JinalkaHerath/Flight_Controller-STM32/schematics/PCB_V2-INNERLAYER.jpg

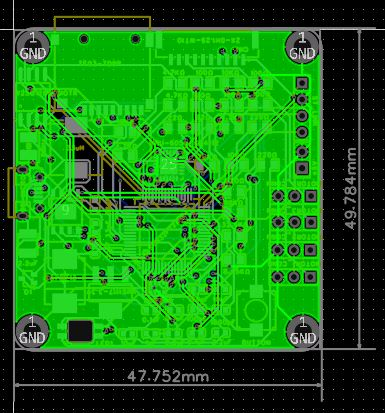
schematics/PCB_V2-INNERLAYER.jpg
