JinalkaHerath/Flight_Controller-STM32/schematics/PCB-BOTTOMLAYER.jpg

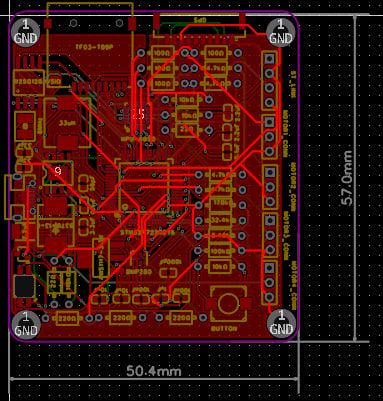
schematics/PCB-BOTTOMLAYER.jpg
