JinalkaHerath/Flight_Controller-STM32/README.md

# Custom STM32F722 Flight Controller

A high-performance flight controller for quadcopters based on STM32F722RET6 microcontroller.

## Features
- STM32F722RET6 (216 MHz Cortex-M7 with FPU)
- MPU6050 6-axis IMU with complementary filter/Madgwick filter
- BMP280 barometer for altitude hold
- GPS navigation (NMEA parser)
- PID control for roll, pitch, yaw, and altitude
- PWM/DShot motor control
- Blackbox logging to W25Q128 flash
- Telemetry via UART

## Hardware
- MCU: STM32F722RET6
- IMU: MPU6050
- Barometer: BMP280
- Flash: W25Q128JVSIM (16MB SPI)
- Power: TPS54360 (5V buck), AMS1117 (3.3V LDO)

## Building
1. Install STM32CubeIDE
2. Clone this repository
3. Import project into CubeIDE
4. Build and flash to target

## Usage
See full documentation in Flight_Controller_report.docx
