JinalkaHerath/Flight_Controller-STM32/schematics/BAROMETER.jpg

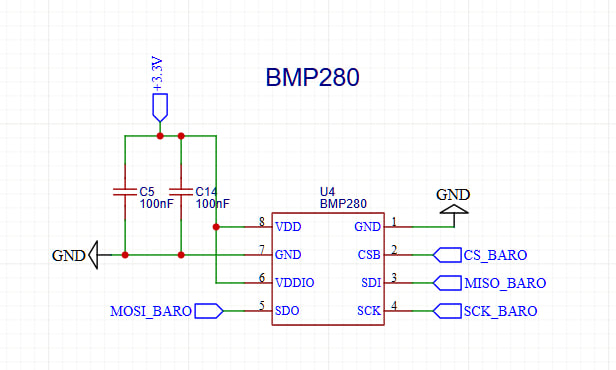
schematics/BAROMETER.jpg
