JinalkaHerath/Flight_Controller-STM32/schematics/BOOT BUTTON.jpg

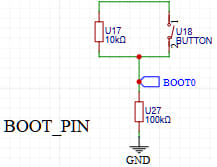
schematics/BOOT BUTTON.jpg
