JinalkaHerath/Flight_Controller-STM32/schematics/PCB-2D.jpg

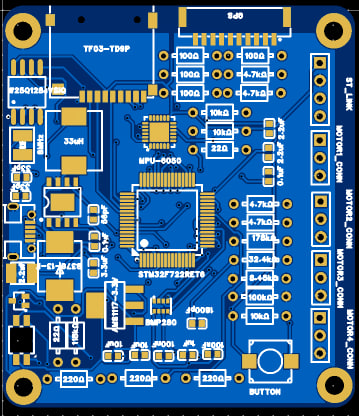
schematics/PCB-2D.jpg
