JinalkaHerath/Flight_Controller-STM32/schematics/PCB-INNER2LAYER.jpg

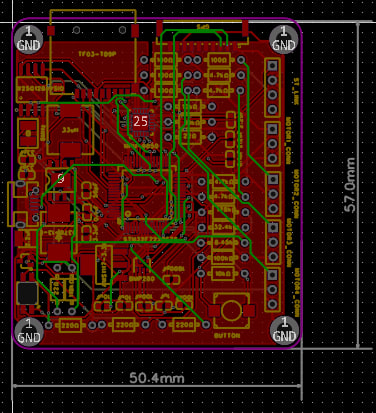
schematics/PCB-INNER2LAYER.jpg
