JinalkaHerath/Flight_Controller-STM32/schematics/PCB-INNERLAYER.jpg

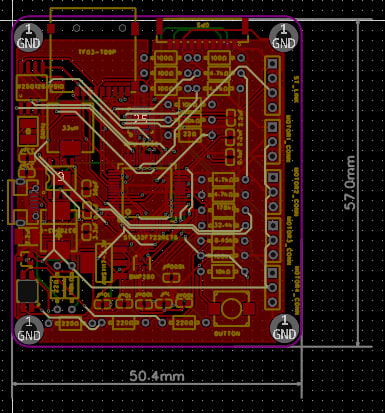
schematics/PCB-INNERLAYER.jpg
