JinalkaHerath/Flight_Controller-STM32/schematics/PCB_V2-2D.jpg

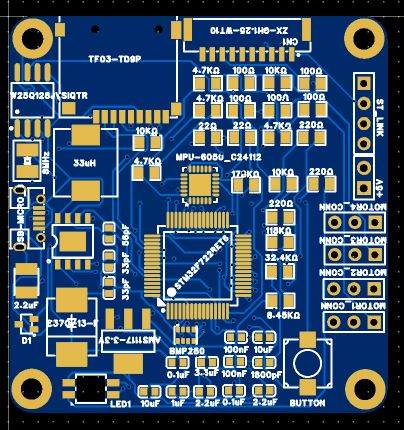
schematics/PCB_V2-2D.jpg
