JinalkaHerath/Flight_Controller-STM32/schematics/PCB_V2-BOTTOMLAYER.jpg

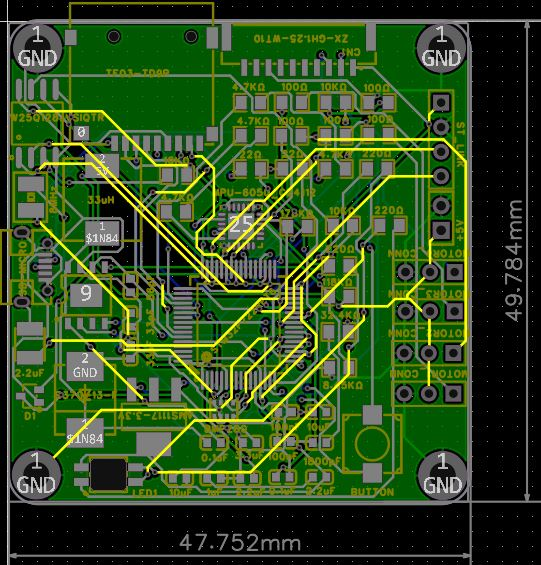
schematics/PCB_V2-BOTTOMLAYER.jpg
