JinalkaHerath/Flight_Controller-STM32/schematics/PCB_V2-TOPLAYER.jpg

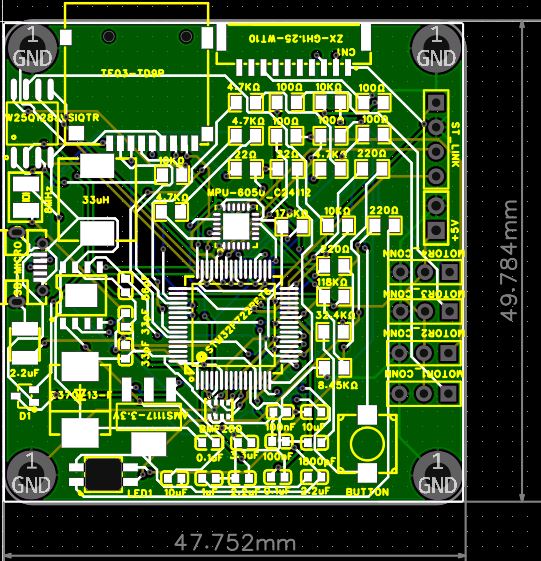
schematics/PCB_V2-TOPLAYER.jpg
