JinalkaHerath/Flight_Controller-STM32/schematics/PCBV_2-INNER2LAYER.jpg

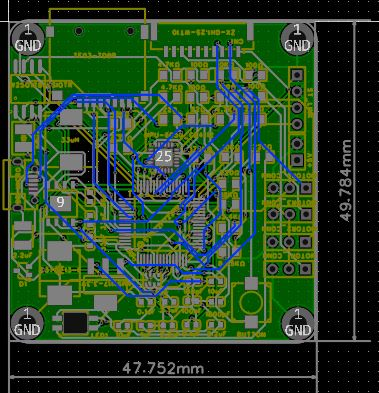
schematics/PCBV_2-INNER2LAYER.jpg
