JinalkaHerath/Flight_Controller-STM32/schematics/pin-config.png

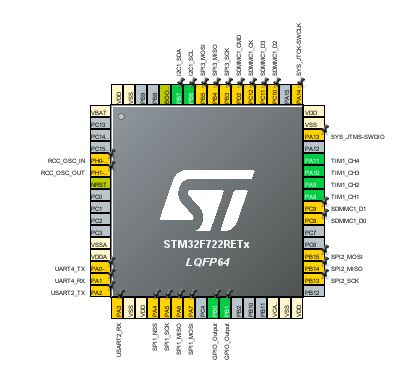
schematics/pin-config.png
