JinalkaHerath/Flight_Controller-STM32/schematics/SD CARD SLOT.jpg

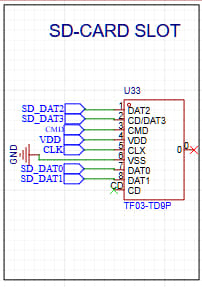
schematics/SD CARD SLOT.jpg
