JinalkaHerath/Flight_Controller-STM32/schematics/STATUS LED.jpg

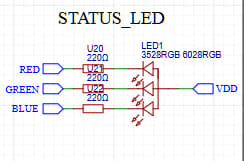
schematics/STATUS LED.jpg
