JinalkaHerath/Flight_Controller-STM32/schematics/STLINK-TO PROGRAM STM32 CHIP.jpg

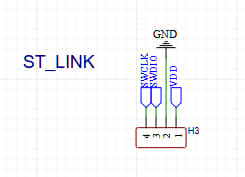
schematics/STLINK-TO PROGRAM STM32 CHIP.jpg
