JinalkaHerath/Flight_Controller-STM32/schematics/FULL-SCHEMATIC_VERSION_2.pdf

# FLASH MEMORY

# 5V-USB VDD GPS_TX

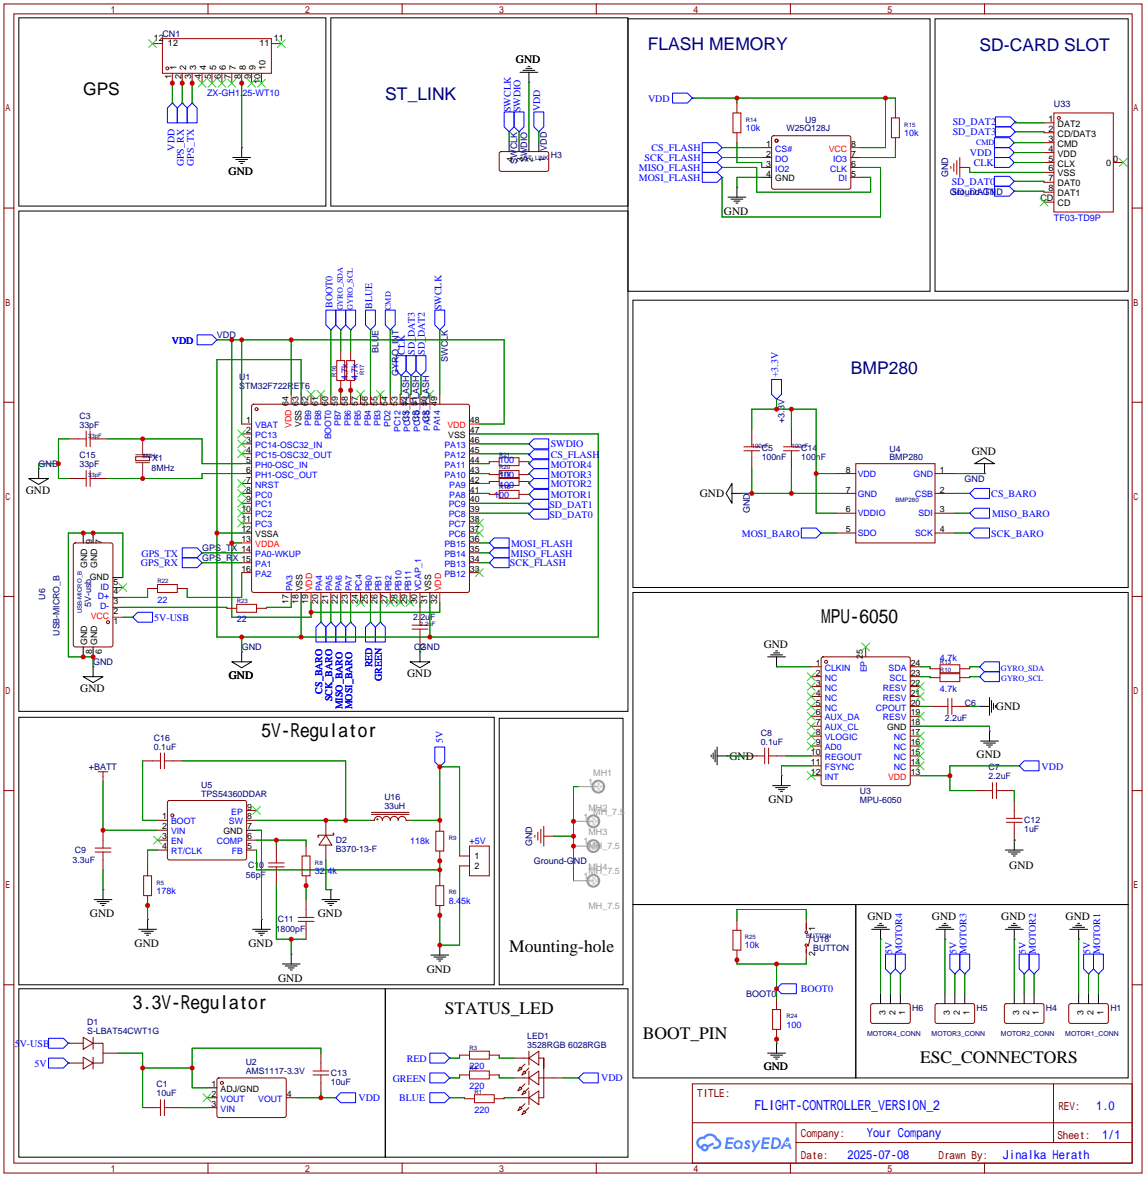
[picture p34: page 1]
