JinalkaHerath/Flight_Controller-STM32/schematics/FULL-SCHEMATIC_VERSION_1.pdf

# FLASH MEMORY

# 5V-usb 5V-USB VDD GPS_TX

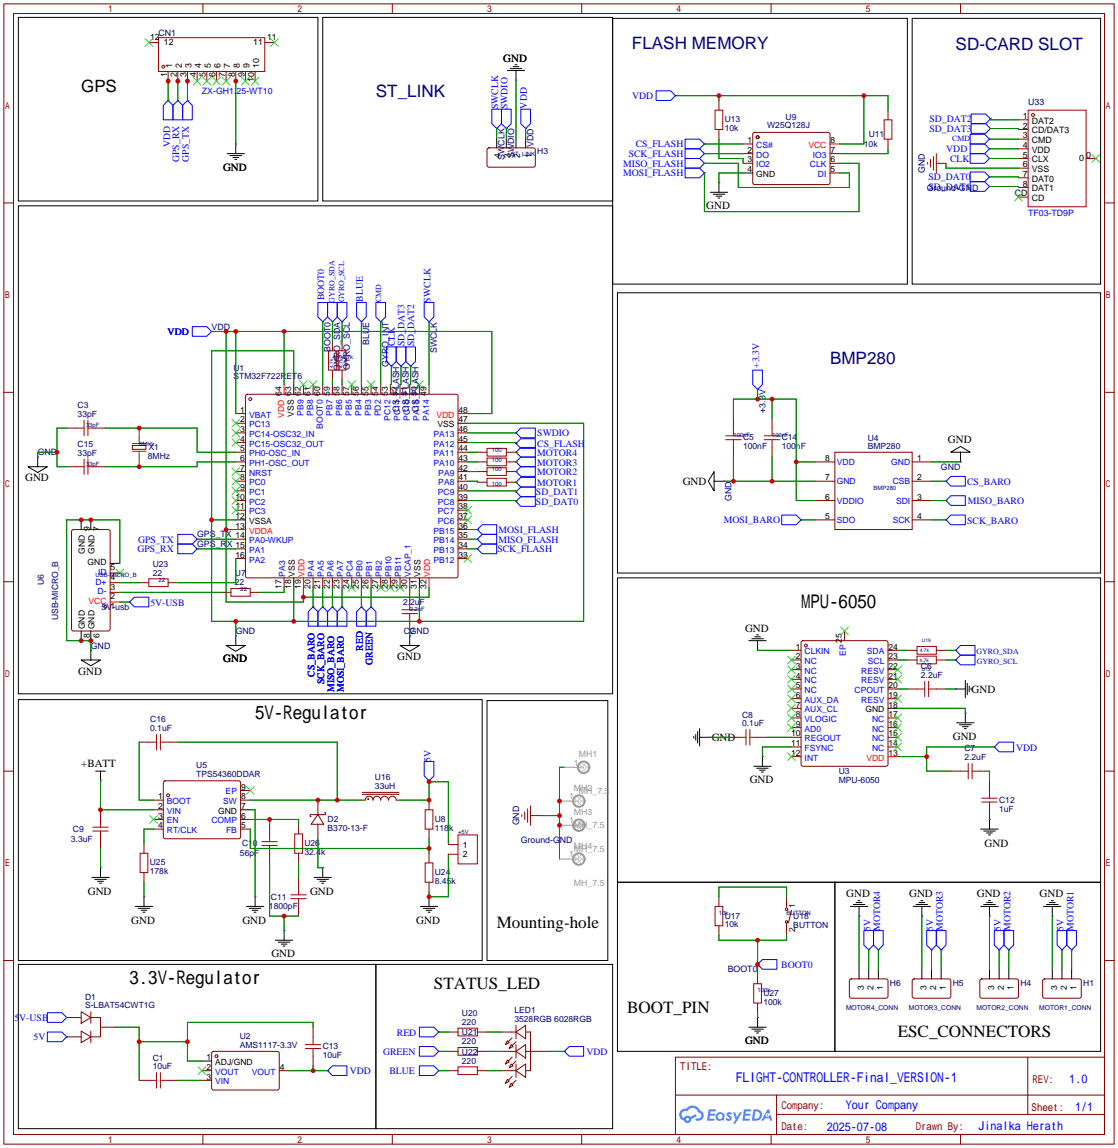
[picture p35: page 1]
