JinalkaHerath/Flight_Controller-STM32/(list of files, drawings)

Other design files:
FLIGHT-CONTROLLER-Final_VERSION-1.eprj
FLIGHT-CONTROLLER_VERSION_2.eprj
