JinalkaHerath/Flight_Controller-STM32/DroneFlightController/Core/Inc/main.h

#define SD_LOG_FILENAME    "flight.csv"
#define SD_GPS_LOG_FILENAME "gps_log.csv"
#define SD_CONFIG_FILENAME "config.txt"
#define FLASH_CONFIG_ADDR  0x000000
#define FLASH_CONFIG_MAGIC 0xAA
#define LOGGING_INTERVAL_MS 100  // 10Hz logging
#define STATUS_UPDATE_MS    200  // 5Hz status updates
#define BUTTON_HOLD_MS     3000  // 3s for button hold
#define GPS_PROCESS_MS     100   // 10Hz GPS processing
#define NAVIGATION_UPDATE_MS 200 // 5Hz navigation updates
#define MAX_DISTANCE_FROM_HOME 500.0f // meters
#define MIN_GPS_SATELLITES 6
#define GPS_ALTITUDE_DEADBAND 2.0f // meters
#define MOTOR1_PIN GPIO_PIN_8
#define MOTOR1_PORT GPIOA
#define MOTOR2_PIN GPIO_PIN_9
#define MOTOR2_PORT GPIOA
#define MOTOR3_PIN GPIO_PIN_10
#define MOTOR3_PORT GPIOA
#define MOTOR4_PIN GPIO_PIN_11
#define MOTOR4_PORT GPIOA
#define SD_CD_PIN GPIO_PIN_12
#define SD_CD_PORT GPIOC
#define FLASH_CS_PIN GPIO_PIN_12
#define FLASH_CS_PORT GPIOB
#define BOOT_BUTTON_PIN GPIO_PIN_0
#define BOOT_BUTTON_PORT GPIOA
#define LED_RED_PIN GPIO_PIN_6
#define LED_RED_PORT GPIOB
#define LED_GREEN_PIN GPIO_PIN_7
#define LED_GREEN_PORT GPIOB
#define LED_BLUE_PIN GPIO_PIN_8
#define LED_BLUE_PORT GPIOB
#define GPS_UART huart6
#define GPS_BAUDRATE 9600
#define DEFAULT_SEA_LEVEL_PRESSURE 1013.25f // hPa
#define SAFE_MOTOR_PULSE_MIN 1000
#define SAFE_MOTOR_PULSE_MAX 2000
#define DEFAULT_TARGET_ALTITUDE 10.0f // meters
