JinalkaHerath/Flight_Controller-STM32/DroneFlightController/DroneFlightController.ioc

Mcu.UserName=STM32F722RETx
PA0-WKUP.Signal=UART4_TX
PA1.Signal=UART4_RX
PA10.Signal=S_TIM1_CH3
PA11.Signal=S_TIM1_CH4
PA13.Signal=SYS_JTMS-SWDIO
PA14.Signal=SYS_JTCK-SWCLK
PA2.Signal=USART2_TX
PA3.Signal=USART2_RX
PA4.Signal=SPI1_NSS
PA5.Signal=SPI1_SCK
PA6.Signal=SPI1_MISO
PA7.Signal=SPI1_MOSI
PA8.Signal=S_TIM1_CH1
PA9.Signal=S_TIM1_CH2
PB0.Signal=GPIO_Output
PB1.Signal=GPIO_Output
PB13.Signal=SPI2_SCK
PB14.Signal=SPI2_MISO
PB15.Signal=SPI2_MOSI
PB3.Signal=SPI3_SCK
PB4.Signal=SPI3_MISO
PB5.Signal=SPI3_MOSI
PB6.Signal=I2C1_SCL
PB7.Signal=I2C1_SDA
PC10.Signal=SDMMC1_D2
PC11.Signal=SDMMC1_D3
PC12.Signal=SDMMC1_CK
PC8.Signal=SDMMC1_D0
PC9.Signal=SDMMC1_D1
PD2.Signal=SDMMC1_CMD
PH0-OSC_IN.Signal=RCC_OSC_IN
PH1-OSC_OUT.Signal=RCC_OSC_OUT
