JinalkaHerath/Flight_Controller-STM32/(notices)

Notices in the files:
DroneFlightController/Core/Inc/main.h:
Copyright (c) 2025 STMicroelectronics.
All rights reserved.
This software is licensed under terms that can be found in the LICENSE file
